chenxiao60/beamformer/README.md

beamformer
==============

Source files for senior tech project
