chenxiao60/beamformer/schematics/beamformer schematic/full schematic.brd

## EAGLE design schematics/beamformer schematic/full schematic.brd (2015-06-06)

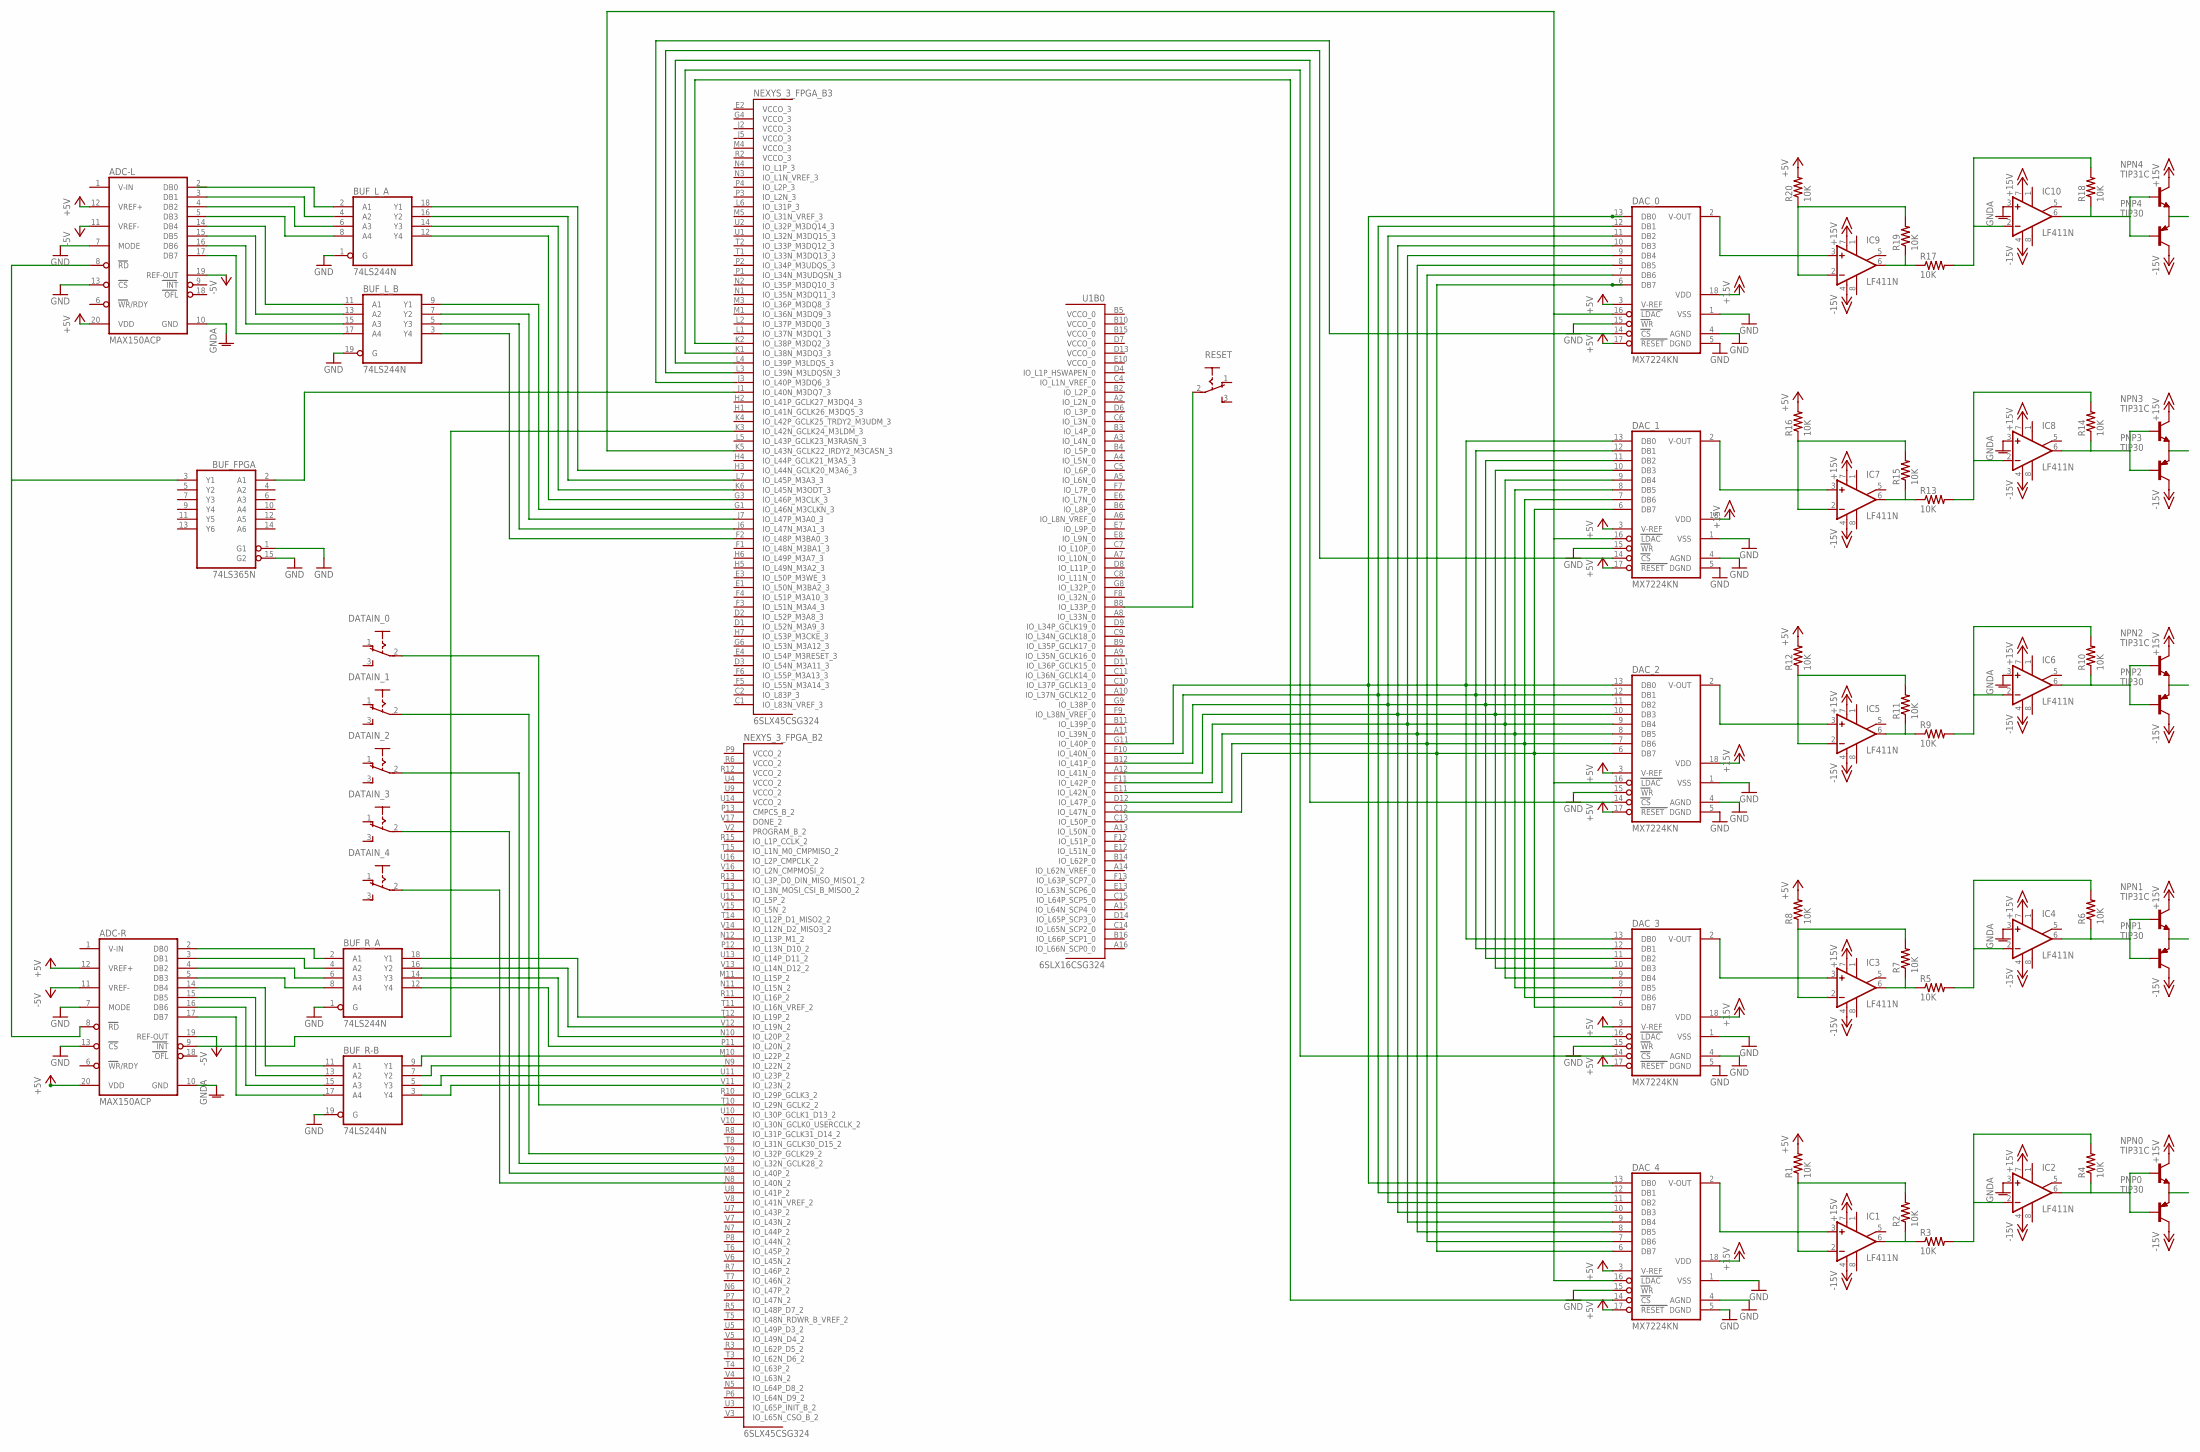
[picture p22: schematic full schematic.sch]

Parts:
ADC-L: MAX150ACP; DIL20
ADC-R: MAX150ACP; DIL20
BUF_FPGA: 74LS365N; DIL16
BUF_L_: 74LS244N; DIL20
BUF_R-: 74LS244N; DIL20
BUF_R_: 74LS244N; DIL20
DAC_0, DAC_1, DAC_2, DAC_3, DAC_4: MX7224KN; DIL18
DATAIN_0, DATAIN_1, DATAIN_2, DATAIN_3, DATAIN_4: M251
IC1, IC2, IC3, IC4, IC5, IC6, IC7, IC8, IC9, IC10: LF411N; DIL08
NEXYS_3_FPGA_: 6SLX45CSG324; CS324
NPN0, NPN1, NPN2, NPN3, NPN4: TIP31C; TO220
PNP0, PNP1, PNP2, PNP3, PNP4: TIP30; TO220
R1, R2, R3, R4, R5, R6, R7, R8, R9, R10, R11, R12, R13, R14, R15, R16, R17, R18, R19, R20: 10K; 0204/7
RESET: M251
U1: 6SLX16CSG324; CS324

Connections:
+5V: ADC-L.12 (VREF+), ADC-L.20 (VDD), ADC-R.12 (VREF+), ADC-R.20 (VDD), DAC_0.3 (V-REF), DAC_0.17 (RESET), DAC_1.3 (V-REF), DAC_1.17 (RESET), DAC_2.3 (V-REF), DAC_2.17 (RESET), DAC_3.3 (V-REF), DAC_3.17 (RESET), DAC_4.3 (V-REF), DAC_4.17 (RESET), R1.2, R8.2, R12.2, R16.2, R20.2
+15V: DAC_0.18 (VDD), DAC_1.18 (VDD), DAC_2.18 (VDD), DAC_3.18 (VDD), DAC_4.18 (VDD), IC1.7 (V+), IC2.7 (V+), IC3.7 (V+), IC4.7 (V+), IC5.7 (V+), IC6.7 (V+), IC7.7 (V+), IC8.7 (V+), IC9.7 (V+), IC10.7 (V+), NPN0.2 (C), NPN1.2 (C), NPN2.2 (C), NPN3.2 (C), NPN4.2 (C)
-5V: ADC-L.11 (VREF-), ADC-L.19 (REF-OUT), ADC-R.11 (VREF-), ADC-R.19 (REF-OUT)
-15V: IC1.4 (V-), IC2.4 (V-), IC3.4 (V-), IC4.4 (V-), IC5.4 (V-), IC6.4 (V-), IC7.4 (V-), IC8.4 (V-), IC9.4 (V-), IC10.4 (V-), PNP0.2 (C), PNP1.2 (C), PNP2.2 (C), PNP3.2 (C), PNP4.2 (C)
GND: ADC-L.7 (MODE), ADC-L.13 (CS), ADC-R.7 (MODE), ADC-R.13 (CS), BUF_FPGA.1 (G1), BUF_FPGA.8 (GND), BUF_FPGA.15 (G2), BUF_L_.1 (G), BUF_L_.10 (GND), BUF_L_.19 (G), BUF_R-.10 (GND), BUF_R-.19 (G), BUF_R_.1 (G), BUF_R_.10 (GND), DAC_0.1 (VSS), DAC_0.4 (AGND), DAC_0.5 (DGND), DAC_0.15 (WR), DAC_1.1 (VSS), DAC_1.4 (AGND), DAC_1.5 (DGND), DAC_1.15 (WR), DAC_2.1 (VSS), DAC_2.4 (AGND), DAC_2.5 (DGND), DAC_2.15 (WR), DAC_3.1 (VSS), DAC_3.4 (AGND), DAC_3.5 (DGND), DAC_3.15 (WR), DAC_4.1 (VSS), DAC_4.4 (AGND), DAC_4.5 (DGND), DAC_4.15 (WR), NEXYS_3_FPGA_.A1 (GND), NEXYS_3_FPGA_.A18 (GND), NEXYS_3_FPGA_.B7 (GND), NEXYS_3_FPGA_.B13 (GND), NEXYS_3_FPGA_.C3 (GND), NEXYS_3_FPGA_.C16 (GND), NEXYS_3_FPGA_.D5 (GND), NEXYS_3_FPGA_.D10 (GND), NEXYS_3_FPGA_.E15 (GND), NEXYS_3_FPGA_.G2 (GND), NEXYS_3_FPGA_.G5 (GND), NEXYS_3_FPGA_.G12 (GND), NEXYS_3_FPGA_.G17 (GND), NEXYS_3_FPGA_.H8 (GND), NEXYS_3_FPGA_.H10 (GND), NEXYS_3_FPGA_.J4 (GND), NEXYS_3_FPGA_.J9 (GND), NEXYS_3_FPGA_.J11 (GND), NEXYS_3_FPGA_.J15 (GND), NEXYS_3_FPGA_.K8 (GND), NEXYS_3_FPGA_.K10 (GND), NEXYS_3_FPGA_.L9 (GND), NEXYS_3_FPGA_.L11 (GND), NEXYS_3_FPGA_.M2 (GND), NEXYS_3_FPGA_.M6 (GND), NEXYS_3_FPGA_.M17 (GND), NEXYS_3_FPGA_.N13 (GND), NEXYS_3_FPGA_.R1 (GND), NEXYS_3_FPGA_.R4 (GND), NEXYS_3_FPGA_.R9 (GND), NEXYS_3_FPGA_.R14 (GND), NEXYS_3_FPGA_.R18 (GND), NEXYS_3_FPGA_.T16 (GND), NEXYS_3_FPGA_.U6 (GND), NEXYS_3_FPGA_.U12 (GND), NEXYS_3_FPGA_.V1 (GND), NEXYS_3_FPGA_.V18 (GND), U1.A1 (GND), U1.A18 (GND), U1.B7 (GND), U1.B13 (GND), U1.C3 (GND), U1.C16 (GND), U1.D5 (GND), U1.D10 (GND), U1.E15 (GND), U1.G2 (GND), U1.G5 (GND), U1.G12 (GND), U1.G17 (GND), U1.H8 (GND), U1.H10 (GND), U1.J4 (GND), U1.J9 (GND), U1.J11 (GND), U1.J15 (GND), U1.K8 (GND), U1.K10 (GND), U1.L9 (GND), U1.L11 (GND), U1.M2 (GND), U1.M6 (GND), U1.M17 (GND), U1.N13 (GND), U1.R1 (GND), U1.R4 (GND), U1.R9 (GND), U1.R14 (GND), U1.R18 (GND), U1.T16 (GND), U1.U6 (GND), U1.U12 (GND), U1.V1 (GND), U1.V18 (GND)
GNDA: ADC-L.10 (GND), ADC-R.10 (GND), IC2.3 (+IN), IC4.3 (+IN), IC6.3 (+IN), IC8.3 (+IN), IC10.3 (+IN)
unnamed: ADC-L.3 (DB1), BUF_L_.4 (A2)
unnamed: ADC-L.4 (DB2), BUF_L_.6 (A3)
unnamed: ADC-L.5 (DB3), BUF_L_.8 (A4)
unnamed: ADC-L.14 (DB4), BUF_L_.11 (A1)
unnamed: ADC-L.15 (DB5), BUF_L_.13 (A2)
unnamed: ADC-L.16 (DB6), BUF_L_.15 (A3)
unnamed: ADC-L.17 (DB7), BUF_L_.17 (A4)
unnamed: ADC-L.8 (RD), ADC-R.8 (RD), BUF_FPGA.3 (Y1)
unnamed: ADC-R.2 (DB0), BUF_R_.2 (A1)
unnamed: ADC-R.3 (DB1), BUF_R_.4 (A2)
unnamed: ADC-R.4 (DB2), BUF_R_.6 (A3)
unnamed: ADC-R.5 (DB3), BUF_R_.8 (A4)
unnamed: ADC-R.14 (DB4), BUF_R-.11 (A1)
unnamed: ADC-R.15 (DB5), BUF_R-.13 (A2)
unnamed: ADC-R.16 (DB6), BUF_R-.15 (A3)
unnamed: ADC-R.17 (DB7), BUF_R-.17 (A4)
unnamed: ADC-R.9 (INT), NEXYS_3_FPGA_.K3 (IO_L42N_GCLK24_M3LDM_3)
unnamed: BUF_FPGA.2 (A1), NEXYS_3_FPGA_.J1 (IO_L40N_M3DQ7_3)
unnamed: DATAIN_0.2, NEXYS_3_FPGA_.T10 (IO_L29N_GCLK2_2)
unnamed: DATAIN_1.2, NEXYS_3_FPGA_.T9 (IO_L32P_GCLK29_2)
unnamed: DATAIN_2.2, NEXYS_3_FPGA_.V9 (IO_L32N_GCLK28_2)
unnamed: DATAIN_3.2, NEXYS_3_FPGA_.M8 (IO_L40P_2)
unnamed: DATAIN_4.2, NEXYS_3_FPGA_.N8 (IO_L40N_2)
unnamed: RESET.2, U1.B8 (IO_L33P_0)
unnamed: BUF_L_.18 (Y1), NEXYS_3_FPGA_.H3 (IO_L44N_GCLK20_M3A6_3)
unnamed: BUF_L_.16 (Y2), NEXYS_3_FPGA_.L7 (IO_L45P_M3A3_3)
unnamed: BUF_L_.14 (Y3), NEXYS_3_FPGA_.K6 (IO_L45N_M3ODT_3)
unnamed: BUF_L_.12 (Y4), NEXYS_3_FPGA_.G3 (IO_L46P_M3CLK_3)
unnamed: BUF_L_.9 (Y1), NEXYS_3_FPGA_.G1 (IO_L46N_M3CLKN_3)
unnamed: BUF_L_.7 (Y2), NEXYS_3_FPGA_.J7 (IO_L47P_M3A0_3)
unnamed: BUF_L_.5 (Y3), NEXYS_3_FPGA_.J6 (IO_L47N_M3A1_3)
unnamed: BUF_L_.3 (Y4), NEXYS_3_FPGA_.F2 (IO_L48P_M3BA0_3)
unnamed: BUF_R_.18 (Y1), NEXYS_3_FPGA_.T12 (IO_L19P_2)
unnamed: BUF_R_.16 (Y2), NEXYS_3_FPGA_.V12 (IO_L19N_2)
unnamed: BUF_R_.14 (Y3), NEXYS_3_FPGA_.N10 (IO_L20P_2)
unnamed: BUF_R_.12 (Y4), NEXYS_3_FPGA_.P11 (IO_L20N_2)
unnamed: BUF_R-.9 (Y1), NEXYS_3_FPGA_.M10 (IO_L22P_2)
unnamed: BUF_R-.7 (Y2), NEXYS_3_FPGA_.N9 (IO_L22N_2)
unnamed: BUF_R-.5 (Y3), NEXYS_3_FPGA_.U11 (IO_L23P_2)
unnamed: BUF_R-.3 (Y4), NEXYS_3_FPGA_.V11 (IO_L23N_2)
unnamed: DAC_0.13 (DB0), DAC_1.13 (DB0), DAC_2.13 (DB0), DAC_3.13 (DB0), DAC_4.13 (DB0), U1.G11 (IO_L40P_0)
unnamed: DAC_0.12 (DB1), DAC_1.12 (DB1), DAC_2.12 (DB1), DAC_3.12 (DB1), DAC_4.12 (DB1), U1.F10 (IO_L40N_0)
unnamed: DAC_0.11 (DB2), DAC_1.11 (DB2), DAC_2.11 (DB2), DAC_3.11 (DB2), DAC_4.11 (DB2), U1.B12 (IO_L41P_0)
unnamed: DAC_0.10 (DB3), DAC_1.10 (DB3), DAC_2.10 (DB3), DAC_3.10 (DB3), DAC_4.10 (DB3), U1.A12 (IO_L41N_0)
unnamed: DAC_0.9 (DB4), DAC_1.9 (DB4), DAC_2.9 (DB4), DAC_3.9 (DB4), DAC_4.9 (DB4), U1.F11 (IO_L42P_0)
unnamed: DAC_0.8 (DB5), DAC_1.8 (DB5), DAC_2.8 (DB5), DAC_3.8 (DB5), DAC_4.8 (DB5), U1.E11 (IO_L42N_0)
unnamed: DAC_0.7 (DB6), DAC_1.7 (DB6), DAC_2.7 (DB6), DAC_3.7 (DB6), DAC_4.7 (DB6), U1.D12 (IO_L47P_0)
unnamed: DAC_0.6 (DB7), DAC_1.6 (DB7), DAC_2.6 (DB7), DAC_3.6 (DB7), DAC_4.6 (DB7), U1.C12 (IO_L47N_0)
unnamed: DAC_0.14 (CS), NEXYS_3_FPGA_.J3 (IO_L40P_M3DQ6_3)
unnamed: DAC_0.16 (LDAC), DAC_1.16 (LDAC), DAC_2.16 (LDAC), DAC_3.16 (LDAC), DAC_4.16 (LDAC), NEXYS_3_FPGA_.K5 (IO_L43N_GCLK22_IRDY2_M3CASN_3)
unnamed: NPN0.3 (E), PNP0.3 (E)
unnamed: DAC_4.2 (V-OUT), IC1.3 (+IN)
unnamed: DAC_3.14 (CS), NEXYS_3_FPGA_.K1 (IO_L38N_M3DQ3_3)
unnamed: IC2.6 (OUT), NPN0.1 (B), PNP0.1 (B), R4.1
unnamed: DAC_4.14 (CS), NEXYS_3_FPGA_.K2 (IO_L38P_M3DQ2_3)
unnamed: IC2.2 (-IN), R3.2, R4.2
unnamed: DAC_2.14 (CS), NEXYS_3_FPGA_.L4 (IO_L39P_M3LDQS_3)
unnamed: DAC_1.14 (CS), NEXYS_3_FPGA_.L3 (IO_L39N_M3LDQSN_3)
unnamed: IC1.6 (OUT), R2.1, R3.1
unnamed: IC1.2 (-IN), R1.1, R2.2
unnamed: DAC_3.2 (V-OUT), IC3.3 (+IN)
unnamed: NPN1.3 (E), PNP1.3 (E)
unnamed: IC4.6 (OUT), NPN1.1 (B), PNP1.1 (B), R6.1
unnamed: IC4.2 (-IN), R5.2, R6.2
unnamed: IC3.2 (-IN), R7.2, R8.1
unnamed: IC3.6 (OUT), R5.1, R7.1
unnamed: DAC_2.2 (V-OUT), IC5.3 (+IN)
unnamed: NPN2.3 (E), PNP2.3 (E)
unnamed: IC6.6 (OUT), NPN2.1 (B), PNP2.1 (B), R10.1
unnamed: IC6.2 (-IN), R9.2, R10.2
unnamed: IC5.2 (-IN), R11.2, R12.1
unnamed: IC5.6 (OUT), R9.1, R11.1
unnamed: DAC_1.2 (V-OUT), IC7.3 (+IN)
unnamed: NPN3.3 (E), PNP3.3 (E)
unnamed: IC8.6 (OUT), NPN3.1 (B), PNP3.1 (B), R14.1
unnamed: IC8.2 (-IN), R13.2, R14.2
unnamed: IC7.2 (-IN), R15.2, R16.1
unnamed: IC7.6 (OUT), R13.1, R15.1
unnamed: DAC_0.2 (V-OUT), IC9.3 (+IN)
unnamed: NPN4.3 (E), PNP4.3 (E)
unnamed: IC10.6 (OUT), NPN4.1 (B), PNP4.1 (B), R18.1
unnamed: IC10.2 (-IN), R17.2, R18.2
unnamed: IC9.2 (-IN), R19.2, R20.1
unnamed: IC9.6 (OUT), R17.1, R19.1
VCC: BUF_FPGA.16 (VCC), BUF_L_.20 (VCC), BUF_R-.20 (VCC), BUF_R_.20 (VCC)

Board: 2 copper layers, 59 parts (0 on the bottom side), 91 nets, no tracks yet.
