chenxiao60/beamformer/schematics/dac pcbs/schematic1.brd

## EAGLE design schematics/dac pcbs/schematic1.brd (2015-06-06)

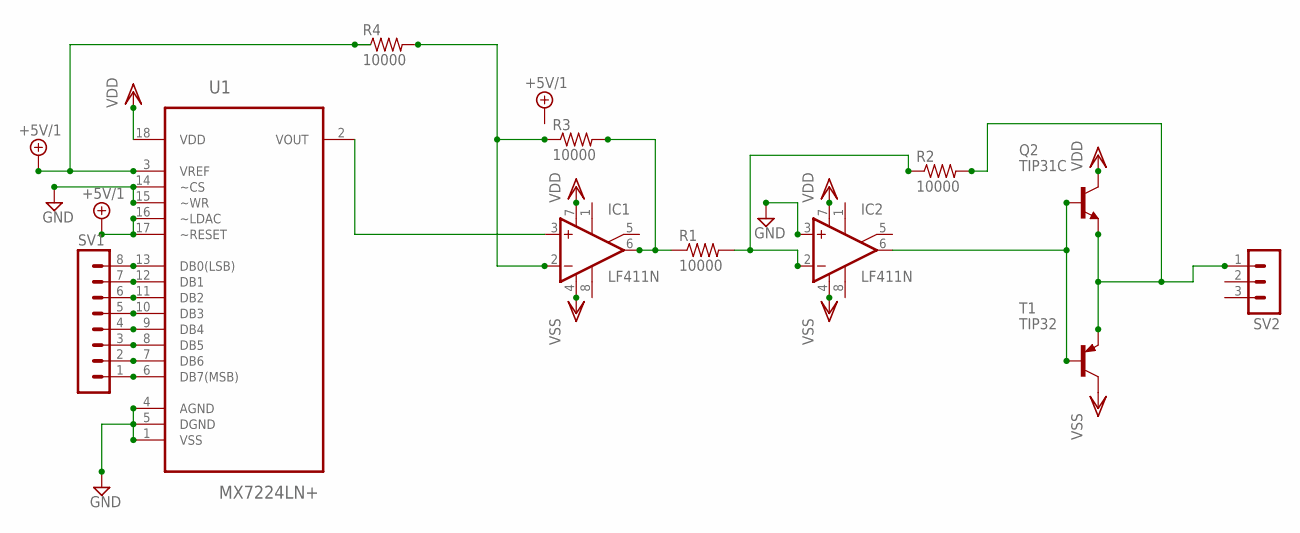
[picture p23: schematic schematic1.sch]

Parts:
IC1, IC2: LF411N; DIL08
Q2: TIP31C; TO220
R1, R2, R3, R4: 10000; 0204/7
SV1: MA08-1W
SV2: MA03-1
T1: TIP32; TO220
U1: MX7224LN+; DIP254P762X457-18

Connections:
+5V/1: R4.1, U1.3 (VREF), U1.16 (~LDAC), U1.17 (~RESET)
GND: IC2.3 (+IN), U1.1 (VSS), U1.4 (AGND), U1.5 (DGND), U1.14 (~CS), U1.15 (~WR)
unnamed: IC1.6 (OUT), R1.1, R3.2
unnamed: IC2.2 (-IN), R1.2, R2.1
unnamed: IC2.6 (OUT), Q2.1 (B), T1.1 (B)
unnamed: IC1.3 (+IN), U1.2 (VOUT)
unnamed: IC1.2 (-IN), R3.1, R4.2
unnamed: SV1.1, U1.6 (DB7(MSB))
unnamed: SV1.2, U1.7 (DB6)
unnamed: SV1.3, U1.8 (DB5)
unnamed: SV1.4, U1.9 (DB4)
unnamed: SV1.5, U1.10 (DB3)
unnamed: SV1.6, U1.11 (DB2)
unnamed: SV1.7, U1.12 (DB1)
unnamed: SV1.8, U1.13 (DB0(LSB))
O0: Q2.3 (E), R2.2, SV2.1, T1.3 (E)
VDD: IC1.7 (V+), IC2.7 (V+), Q2.2 (C), U1.18 (VDD)
VSS: IC1.4 (V-), IC2.4 (V-), T1.2 (C)

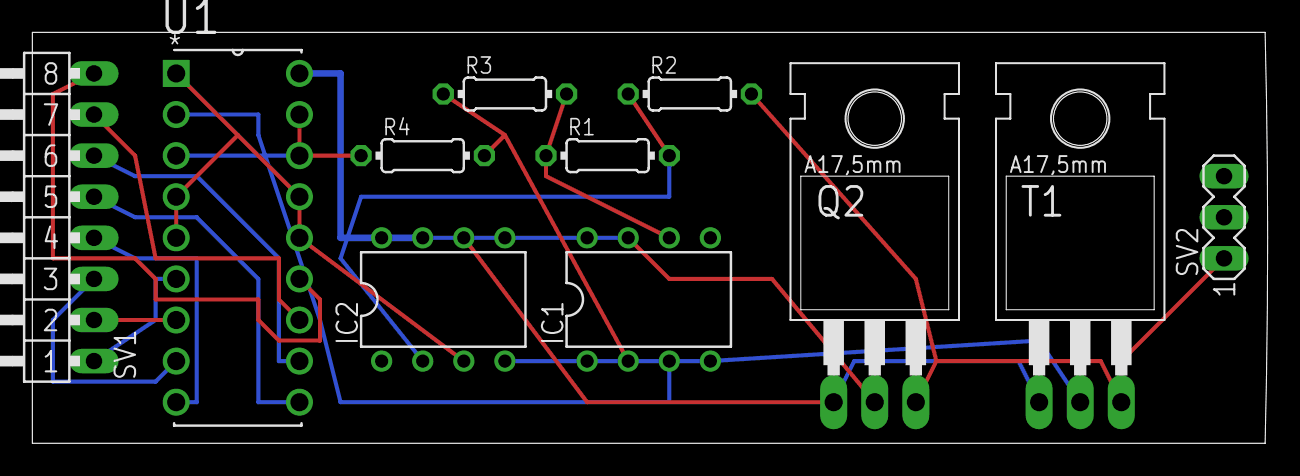
[picture p24: board schematic1.brd from above]

Board: 2 copper layers, 76.4 x 25.4 mm, 11 parts (0 on the bottom side), 18 nets.
