chenxiao60/beamformer/hdl/toplevel_nearfield.vhd

----------------------------------------------------------------------------------
-- Created by Sam Rohrer                                                        --
-- Beamforms in the nearfield based on a generic for distance                   -- 
-- This is the toplevel file (to configure the FPGA)                            --
----------------------------------------------------------------------------------
library IEEE;
use IEEE.STD_LOGIC_1164.ALL;
use IEEE.NUMERIC_STD.ALL;

entity toplevel_nearfield is
	generic(
	sample_divisor     : integer := 11
	);

	port(
	sys_clock           : in     std_logic; -- system clk signal
	swt_distance        : in     std_logic_vector (4 downto 0); -- switch 0 to 4
	but_reset           : in     std_logic ; --Button D
	
	pin_dataout         :    out std_logic_vector (7 downto 0); -- JA 0 to 7 
	pin_channel         :    out std_logic_vector (4 downto 0); -- JB 0 to 4
	
	pin_datain_r        : in     std_logic_vector (7 downto 0); -- JC 0 to 7
	pin_datain_l        : in     std_logic_vector (7 downto 0); -- JD 0 to 7
	
	pin_int             : in     std_logic; -- JB5
	
	pin_speaker_enable  :    out std_logic; --JB7
	
	pin_rd              :    out std_logic --JB6
		
	);
	
end toplevel_nearfield;

architecture Behavioral of toplevel_nearfield is
	
	--******************* Signal Processing ***************--
	component nearfield_processing is
		
		generic(
		divisor           : integer := 50; -- difference between system clock 1 us 
		speed_sound       : integer := 13397; -- in inches/second
		speaker_distance  : integer := 2; -- in inches
		sample_period     : integer := 22
		);
	
		port(
		i_datain_r        : in     std_logic_vector (7 downto 0); -- 8 bit from memory
		i_datain_l        : in     std_logic_vector (7 downto 0); -- 8 bit from memory
		i_clock           : in     std_logic;                     -- 
		i_distance        : in     std_logic_vector (4 downto 0); -- Switches determine distance
		i_reset           : in     std_logic ;                    -- To reset the entire system
		i_sampleclock     : in     std_logic ;                    -- Rate at which the music is playing
	
		o_speaker_enable  :    out std_logic; --LDAC enable	
		o_dataout         :    out std_logic_vector (7 downto 0); -- 8 bit to be multiplexed 
		o_channel         :    out std_logic_vector (4 downto 0);  -- 5 bit to select which DAC to enable
		o_us_clock        :    out std_logic
		);
		
	end component;
	
	--**************** User Signals ***************--
	
	signal clockpulses     : integer range 0 to 2200;
	signal us_clockpulses  : integer range 0 to 12;	
	
	signal sample_clock    : std_logic;
	
	signal us_clock        : std_logic;	
	
	signal sig_datain_r    : std_logic_vector (7 downto 0);
	signal sig_datain_l    : std_logic_vector (7 downto 0);

	--**************** End User Signals ***********--

begin
	
	--*************** User Processes **************--
	sampleclock_division : process(but_reset, us_clock)
	begin
		if (but_reset = '1') then
			us_clockpulses           <= 0;
			sample_clock             <= '0';
		elsif(rising_edge(us_clock)) then
			us_clockpulses           <= us_clockpulses + 1 ;
			if(us_clockpulses = (sample_divisor-1)) then 
				sample_clock         <= Not sample_clock;
				us_clockpulses       <= 0;
			end if;		
		end if;
	end process;
	
	rd_control : process (but_reset, sys_clock, clockpulses, sample_clock)
	begin
		if (but_reset = '1' ) then 
			pin_rd           <= '1';
			clockpulses      <= 0;
		elsif (rising_edge(sys_clock)) then
			clockpulses      <= clockpulses + 1;
			if (clockpulses = 0) then
				pin_rd       <= '0';
			elsif (clockpulses = 250) then 
				pin_rd       <= '1';
			elsif(pin_int = '0') then
				sig_datain_r <= pin_datain_r;
				sig_datain_l <= pin_datain_l;
			elsif(rising_edge(sample_clock)) then
				clockpulses  <= 0;
			end if;

		end if;
	end process;	
	
	--*************** End User Processes **********--
	
--**************** Signal Processing Port Map ***********--	
	
	fpga : nearfield_processing
	generic map(
		divisor             => 50,
		speed_sound         => 13397,
		speaker_distance    => 2,
		sample_period       => 22
		)

	port map(
		i_datain_r          => sig_datain_r,
		i_datain_l          => sig_datain_l,
		i_clock             => sys_clock,
		i_distance          => swt_distance,
		i_reset             => but_reset,
		i_sampleclock       => sample_clock,

		o_speaker_enable    => pin_speaker_enable,
		o_dataout           => pin_dataout,
		o_channel           => pin_channel,
		o_us_clock          => us_clock
		);
		
end Behavioral;
