chenxiao60/beamformer/(commit log)

2013-12-12 initial dac timing fix
    [toplevel_nearfield.vhd]
2014-02-27 changed sample period
2014-03-07 sample period update
2014-03-11 fixed sample_edges
2014-03-13 changed sample timing
2014-03-13 updated pin names & changed sampling method
2014-03-14 fixed sample_period sensitivity list issue
2014-03-14 fixed sample updating
2014-03-26 switched type of distance
2015-06-06 added schematics and papers
    [full schematic.brd, full schematic.sch, schematic1.brd, schematic1.sch]
2015-06-06 updated schematics
